MuhammadAbdullahGhazi/PID-Liquid-Filling-Machine/pump.webp

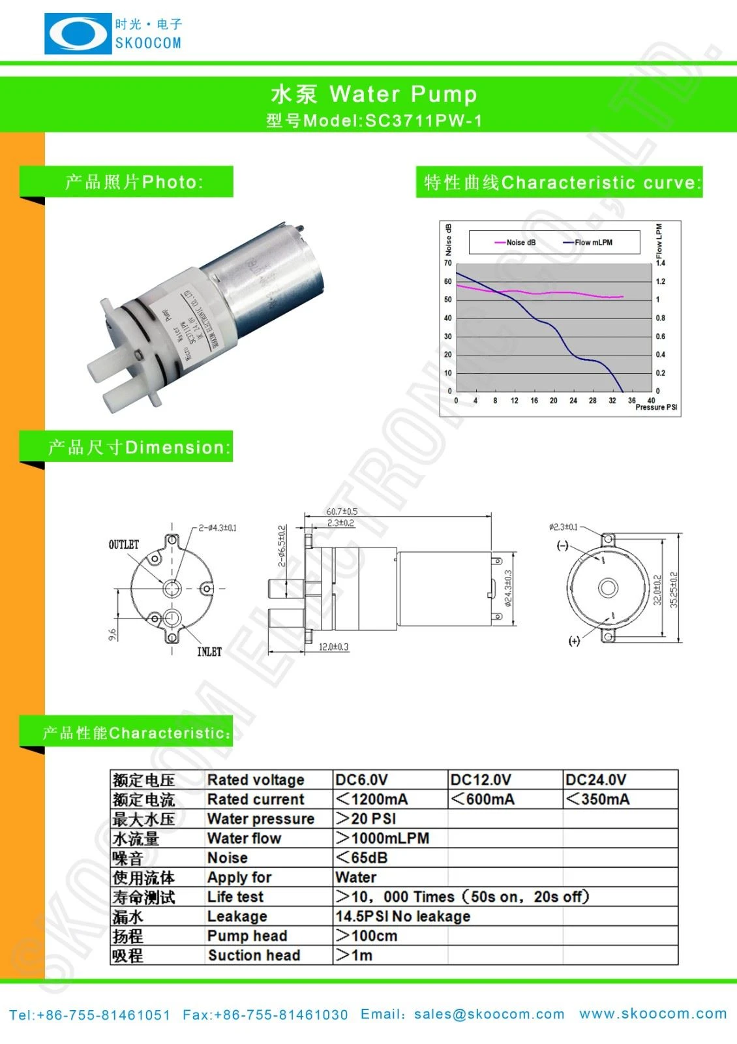
pump.webp
