MuhammadAbdullahGhazi/PID-Liquid-Filling-Machine/Pump Parameters_2.png

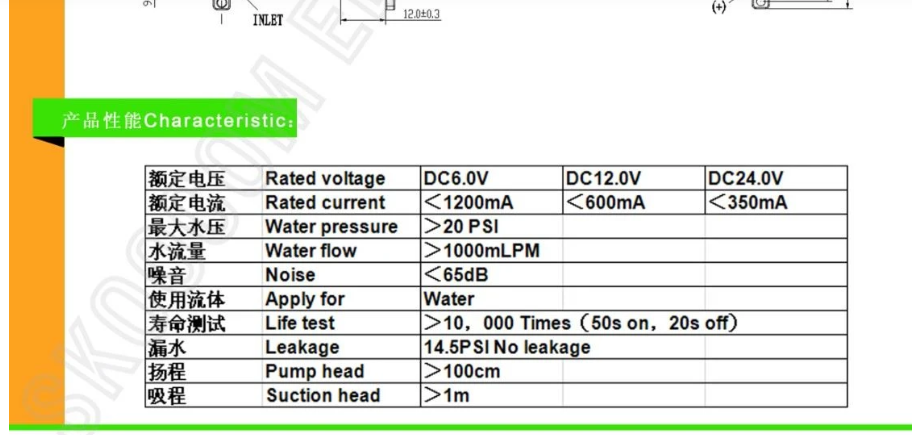
Pump Parameters_2.png
