MuhammadAbdullahGhazi/PID-Liquid-Filling-Machine/README.md

# PID-Liquid-Filling-Machine
Automatic Weight-Based Liquid Filling Machine
