MuhammadAbdullahGhazi/PID-Liquid-Filling-Machine/machine_no_bg.png

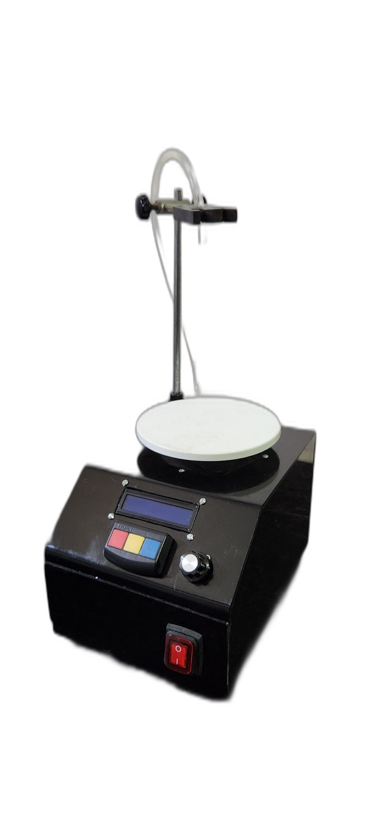
machine_no_bg.png
