MuhammadAbdullahGhazi/PID-Liquid-Filling-Machine/Pump Parameters.png

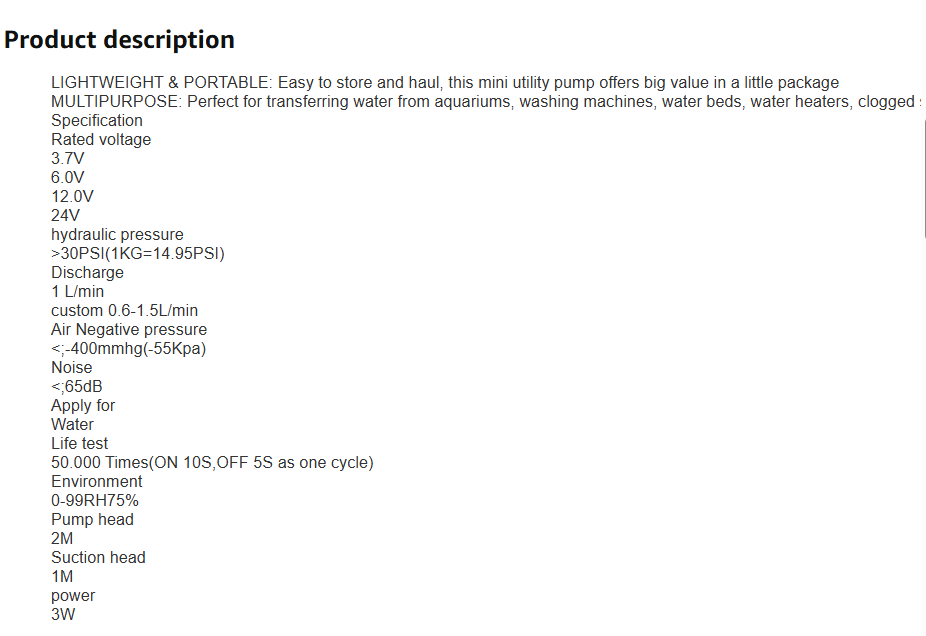
Pump Parameters.png
