MuhammadAbdullahGhazi/PID-Liquid-Filling-Machine/Liquid_Filling_Machine_3D_Model.dxf

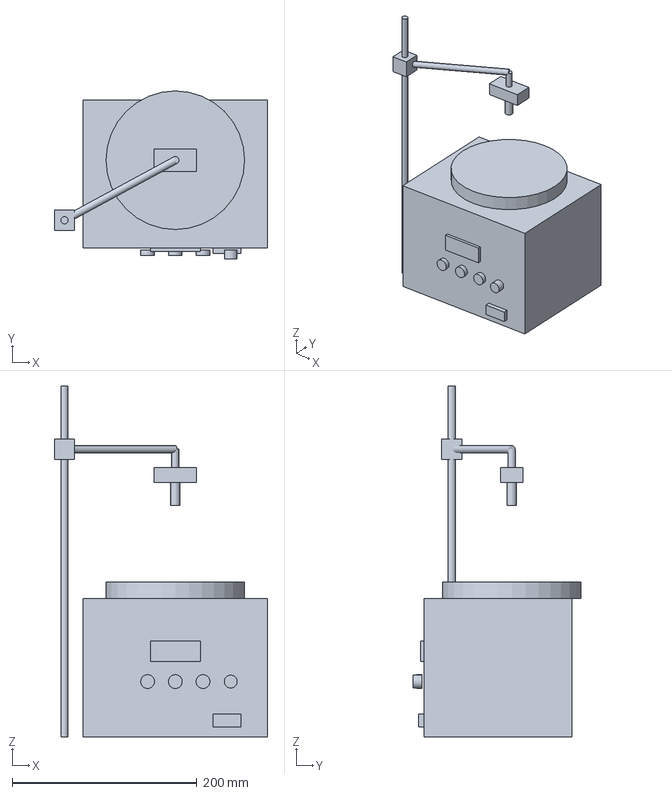
[picture p5: CAD file, 2026-10-30]
Liquid_Filling_Machine_3D_Model.dxf
231.0 x 182.0 x 380.0 mm
