MuhammadAbdullahGhazi/PID-Liquid-Filling-Machine/pinout1.pdf

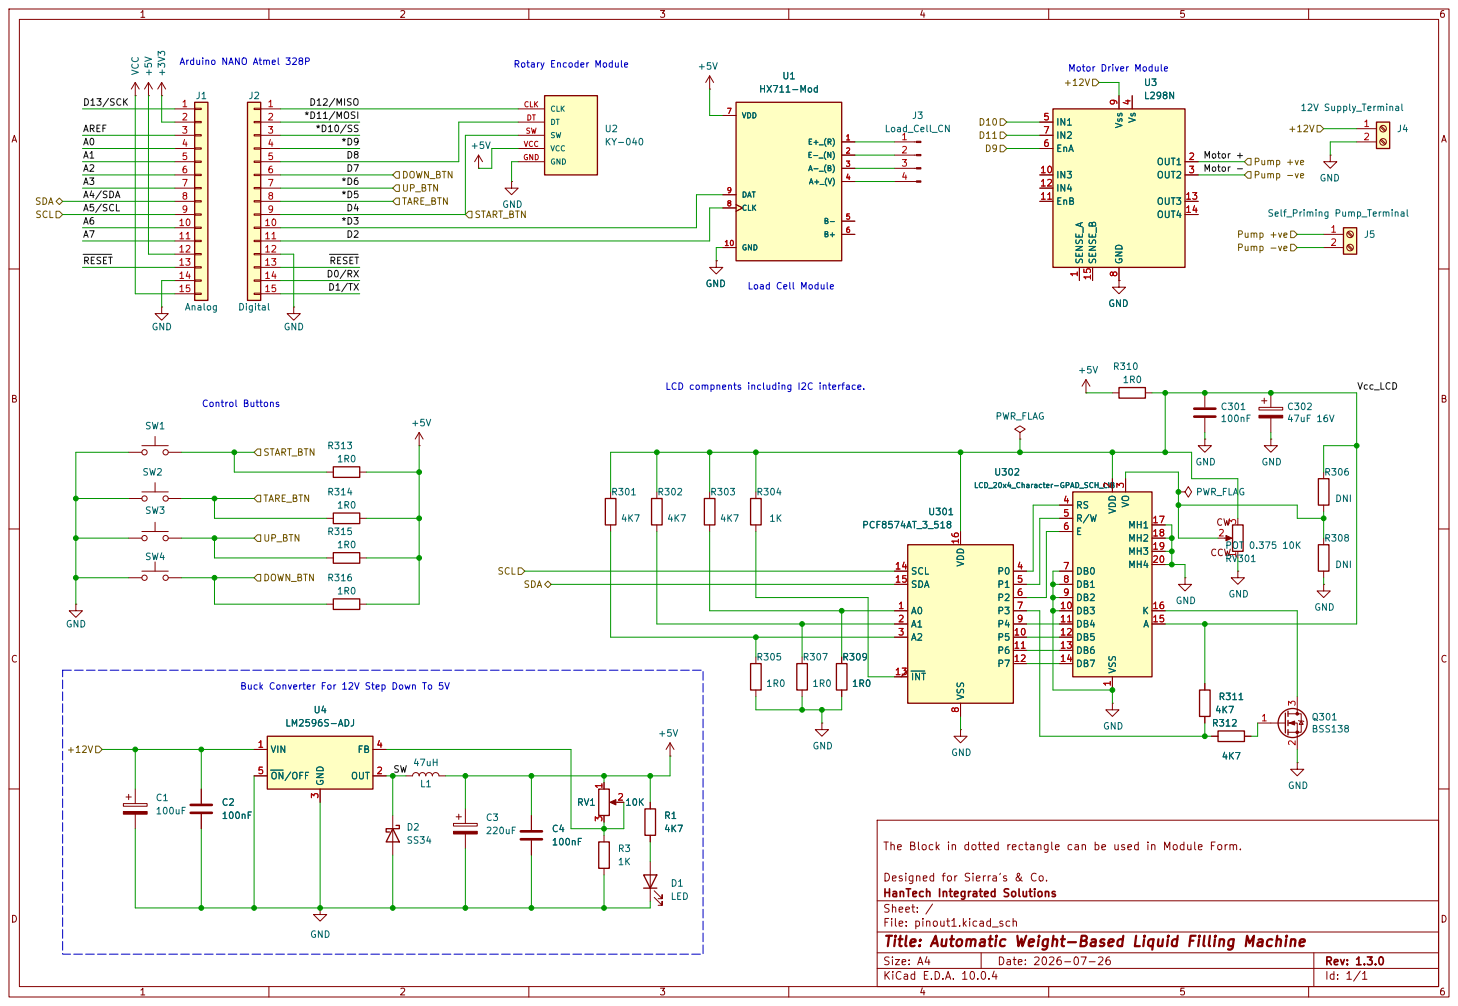
[picture p6: page 1]

Load Cell Module Buck Converter For 12V Step Down To 5V

The Block in dotted rectangle can be used in Module Form. C4

Designed for Sierra's & Co.
HanTech Integrated Solutions
Sheet: /
File: pinout1.kicad_sch
Title: Automatic Weight-Based Liquid Filling Machine

Size: A4 | Rev: 1.3.0
KiCad E.D.A. 10.0.4 | Id: 1/1
